Open-Laboratory/safeduino_mega_328/kicad/safeduino_mega_328.kicad_pcb

## KiCad design kicad/safeduino_mega_328.kicad_pcb (2023-07-11)

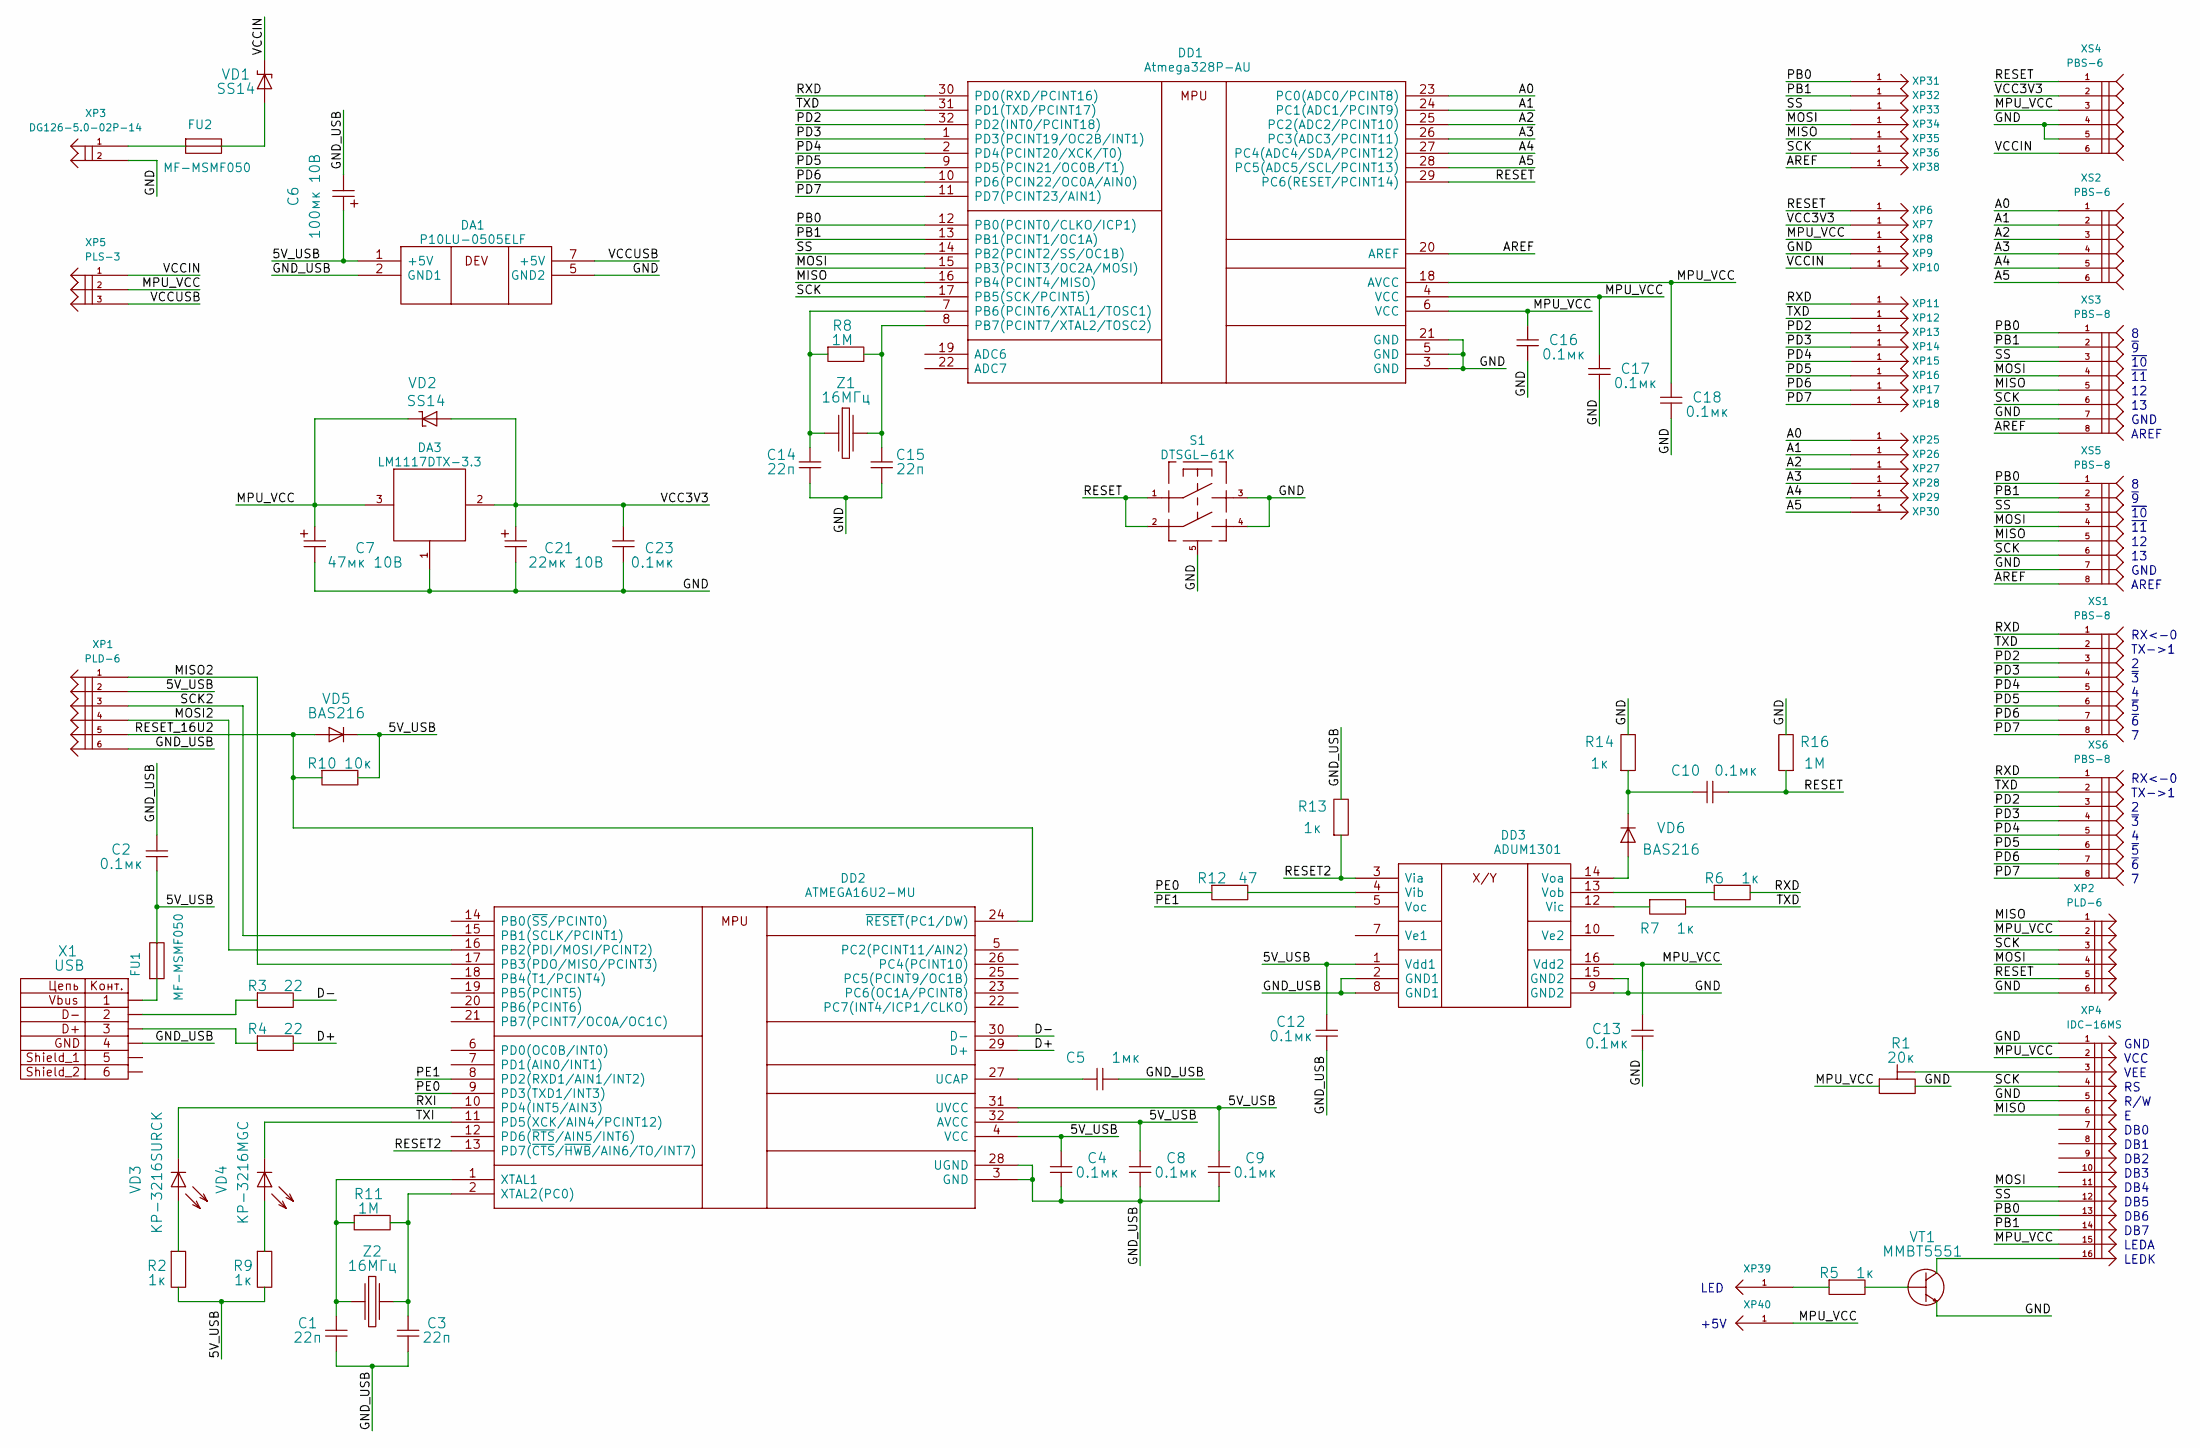
[picture p1: schematic safeduino_mega_328.kicad_sch, SafeDuino MEGA 328]

Parts:
C1, C3, C14, C15: 22п
C2, C4, C8, C9, C10, C12, C13, C16, C17, C18, C23: 0.1мк
C5: 1мк
C6: 100мк 10В
C7: 47мк 10В
C21: 22мк 10В
DA1: P10LU-0505ELF
DA3: LM1117DTX-3.3
DD1: Atmega328P-AU
DD2: ATMEGA16U2-MU
DD3: ADUM1301
FU1, FU2: MF-MSMF050
R1: 20к
R2, R5, R6, R7, R9, R13, R14: 1к
R3, R4: 22
R8, R11, R16: 1M
R10: 10к
R12: 47
S1: DTSGL-61K
VD1, VD2: SS14
VD3: KP-3216SURCK
VD4: KP-3216MGC
VD5, VD6: BAS216
VT1: MMBT5551
X1: USB
XP1, XP2: PLD-6
XP3: DG126-5.0-02P-14
XP4: IDC-16MS
XP5: PLS-3
XP6, XP7, XP8, XP9, XP10, XP11, XP12, XP13, XP14, XP15, XP16, XP17, XP18, XP25, XP26, XP27, XP28, XP29, XP30, XP31, XP32, XP33, XP34, XP35, XP36, XP38, XP39, XP40: (no value)
XS1, XS3, XS5, XS6: PBS-8
XS2, XS4: PBS-6
Z1, Z2: 16МГц

Connections:
/5V_USB: C2.1, C4.2, C6.1, C8.2, C9.2, C12.2, DA1.1 (+5V), DD2.4 (VCC), DD2.31 (UVCC), DD2.32 (AVCC), DD3.1 (Vdd1), FU1.2, R2.2, R9.2, R10.2, VD5.2, XP1.2
/A0: DD1.23 (PC0(ADC0/PCINT8)), XP25.1, XS2.1
/A1: DD1.24 (PC1(ADC1/PCINT9)), XP26.1, XS2.2
/A2: DD1.25 (PC2(ADC2/PCINT10)), XP27.1, XS2.3
/A3: DD1.26 (PC3(ADC3/PCINT11)), XP28.1, XS2.4
/A4: DD1.27 (PC4(ADC4/SDA/PCINT12)), XP29.1, XS2.5
/A5: DD1.28 (PC5(ADC5/SCL/PCINT13)), XP30.1, XS2.6
/AREF: DD1.20 (AREF), XP38.1, XS3.8, XS5.8
/D+: DD2.29 (D+), R4.2
/D-: DD2.30 (D-), R3.2
/GND: C7.2, C13.1, C14.2, C15.2, C16.2, C17.2, C18.2, C21.2, C23.2, DA1.5 (GND2), DA3.1 (com), DD1.3 (GND), DD1.5 (GND), DD1.21 (GND), DD3.9 (GND2), DD3.15 (GND2), R1.3, R14.2, R16.2, S1.3, S1.4, S1.5, VT1.1, XP2.6, XP3.2, XP4.1, XP4.5, XP9.1, XS3.7, XS4.4, XS4.5, XS5.7
/GND_USB: C1.2, C2.2, C3.2, C4.1, C5.2, C6.2, C8.1, C9.1, C12.1, DA1.2 (GND1), DD2.3 (GND), DD2.28 (UGND), DD3.2 (GND1), DD3.8 (GND1), R13.2, X1.4 (GND), XP1.6
/MISO: DD1.16 (PB4(PCINT4/MISO)), XP2.1, XP4.6, XP35.1, XS3.5, XS5.5
/MISO2: DD2.17 (PB3(PDO/MISO/PCINT3)), XP1.1
/MOSI: DD1.15 (PB3(PCINT3/OC2A/MOSI)), XP2.4, XP4.11, XP34.1, XS3.4, XS5.4
/MOSI2: DD2.16 (PB2(PDI/MOSI/PCINT2)), XP1.4
/MPU_VCC: C7.1, C13.2, C16.1, C17.1, C18.1, DA3.3 (Vin), DD1.4 (VCC), DD1.6 (VCC), DD1.18 (AVCC), DD3.16 (Vdd2), R1.1, VD2.2, XP2.2, XP4.2, XP4.15, XP5.2, XP8.1, XP40.1, XS4.3
/PB0: DD1.12 (PB0(PCINT0/CLKO/ICP1)), XP4.13, XP31.1, XS3.1, XS5.1
/PB1: DD1.13 (PB1(PCINT1/OC1A)), XP4.14, XP32.1, XS3.2, XS5.2
/PD2: DD1.32 (PD2(INT0/PCINT18)), XP13.1, XS1.3, XS6.3
/PD3: DD1.1 (PD3(PCINT19/OC2B/INT1)), XP14.1, XS1.4, XS6.4
/PD4: DD1.2 (PD4(PCINT20/XCK/T0)), XP15.1, XS1.5, XS6.5
/PD5: DD1.9 (PD5(PCIN21/OC0B/T1)), XP16.1, XS1.6, XS6.6
/PD6: DD1.10 (PD6(PCIN22/OC0A/AIN0)), XP17.1, XS1.7, XS6.7
/PD7: DD1.11 (PD7(PCINT23/AIN1)), XP18.1, XS1.8, XS6.8
/PE0: DD2.9 (PD3(TXD1/INT3)), R12.1
/PE1: DD2.8 (PD2(RXD1/AIN1/INT2)), DD3.5 (Voc)
/RESET: C10.2, DD1.29 (PC6(RESET/PCINT14)), R16.1, S1.1, S1.2, XP2.5, XP6.1, XS4.1
/RESET2: DD2.13 (PD7(~CTS/~HWB/AIN6/TO/INT7)), DD3.3 (Via), R13.1
/RESET_16U2: DD2.24 (~RESET(PC1/DW)), R10.1, VD5.1, XP1.5
/RXD: DD1.30 (PD0(RXD/PCINT16)), R6.2, XP11.1, XS1.1, XS6.1
/RXI: DD2.10 (PD4(INT5/AIN3)), VD3.2
/SCK: DD1.17 (PB5(SCK/PCINT5)), XP2.3, XP4.4, XP36.1, XS3.6, XS5.6
/SCK2: DD2.15 (PB1(SCLK/PCINT1)), XP1.3
/SS: DD1.14 (PB2(PCINT2/SS/OC1B)), XP4.12, XP33.1, XS3.3, XS5.3
/TXD: DD1.31 (PD1(TXD/PCINT17)), R7.2, XP12.1, XS1.2, XS6.2
/TXI: DD2.11 (PD5(XCK/AIN4/PCINT12)), VD4.2
/VCC3V3: C21.1, C23.1, DA3.2 (Vout), VD2.1, XP7.1, XS4.2
/VCCIN: VD1.2, XP5.1, XP10.1, XS4.6
/VCCUSB: DA1.7 (+5V), XP5.3
unnamed: C1.1, DD2.1 (XTAL1), R11.1, Z2.1
unnamed: C3.1, DD2.2 (XTAL2(PC0)), R11.2, Z2.2
unnamed: C5.1, DD2.27 (UCAP)
unnamed: C10.1, R14.1, VD6.2
unnamed: C14.1, DD1.7 (PB6(PCINT6/XTAL1/TOSC1)), R8.1, Z1.1
unnamed: C15.1, DD1.8 (PB7(PCINT7/XTAL2/TOSC2)), R8.2, Z1.2
unnamed: DD3.4 (Vib), R12.2
unnamed: DD3.12 (Vic), R7.1
unnamed: DD3.13 (Vob), R6.1
unnamed: DD3.14 (Voa), VD6.1
unnamed: FU1.1, X1.1 (Vbus)
unnamed: FU2.1, XP3.1
unnamed: FU2.2, VD1.1
unnamed: R1.2, XP4.3
unnamed: R2.1, VD3.1
unnamed: R3.1, X1.2 (D-)
unnamed: R4.1, X1.3 (D+)
unnamed: R5.1, XP39.1
unnamed: R5.2, VT1.2
unnamed: R9.1, VD4.1
unnamed: VT1.3, XP4.16

Notes on the sheet:
GND
RX<-0
DB2
AREF
TX->1
~{3}
DB6
DB5
~{6}
LEDA
DB7
LED
~{5}
VEE
DB3
~{10}
~{9}
DB1
~{11}
LEDK
+5V
R/W
DB4
VCC
DB0

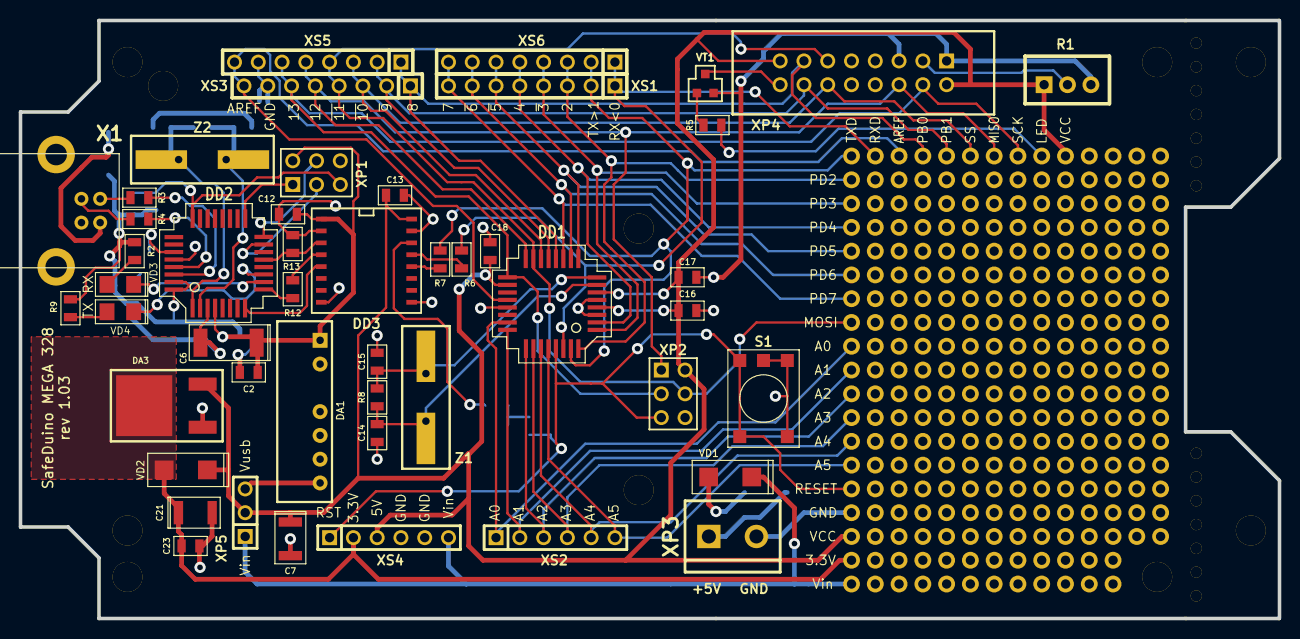
[picture p2: board safeduino_mega_328.kicad_pcb from above]

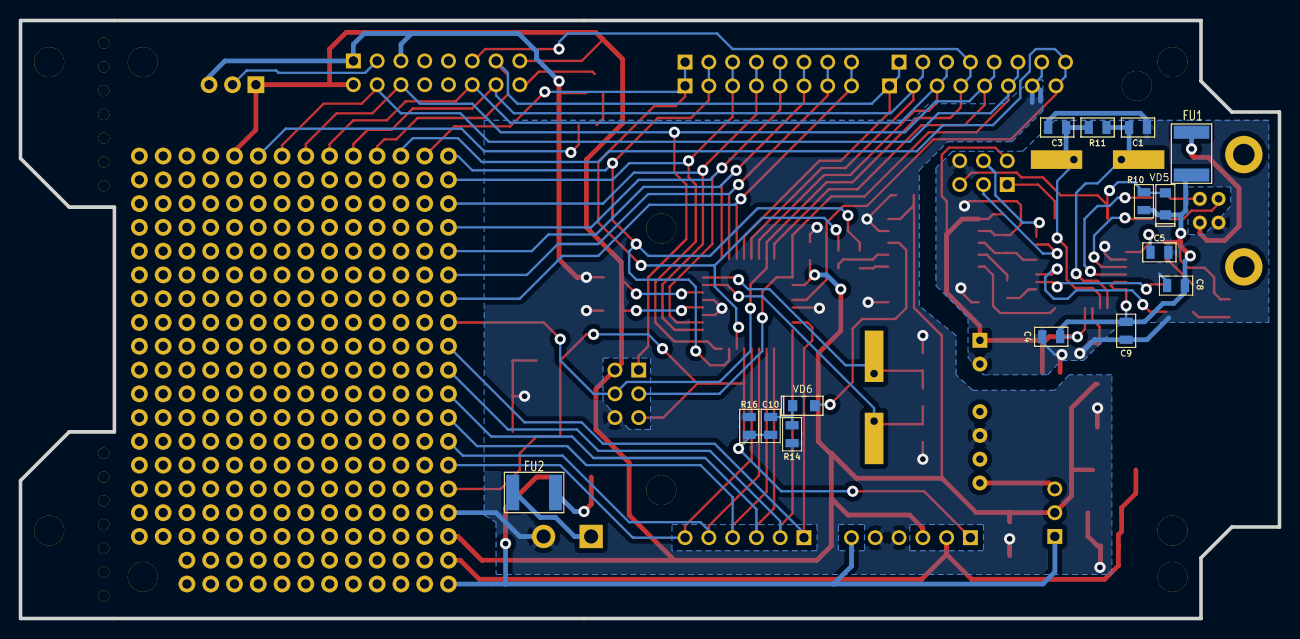
[picture p3: board safeduino_mega_328.kicad_pcb from below]

Board: 2 copper layers, 134.5 x 63.9 mm, 101 parts (15 on the bottom side), 61 nets.

Other parts of the board:
G447, G447#2, G447#3, G762/G447/HB11460: P***; 1_pin
HB11460/G762, HB11460/G762#2, HB11460/G762/arduino: P***; 1_pin
arduino: P***; 1_pin
arduino#2, arduino#3: P***; 1_pin
