Open-Laboratory/safeduino_mega_328/(commit log)

2016-02-19 Заменил FTDI на Atmega16u2.
    [safeduino_mega_328.sch]
2016-02-19 Начал переразводить печатную плату.
    [safeduino_mega_328.kicad_pcb, safeduino_mega_328.sch]
2016-02-20 Закончил разводку платы.
    [safeduino_mega_328.kicad_pcb]
2016-02-24 Добавил самовостанавливающиеся предохренители на 0.5А.
    [safeduino_mega_328.kicad_pcb, safeduino_mega_328.sch]
2016-03-10 Заменил резистор R15 на диод VD6 для защиты ADUM от попадания напряжения.
    [safeduino_mega_328.kicad_pcb, safeduino_mega_328.sch]
2016-05-23 SafeDuino MEGA 328 v1.02 полностью готова к отправке на изготовление.
    [safeduino_mega_328.kicad_pcb, safeduino_mega_328.sch]
2016-07-13 Исправли ошибку на плате SafeDuino MEGA 328(был не соединён контакт PE0 на плате).
    [safeduino_mega_328.kicad_pcb, safeduino_mega_328.sch]
2018-07-20 Поправил шелкографию на плате.
    [safeduino_mega_328.kicad_pcb]
2023-07-11 Перевёл проект на Kicad 6.0.
    [safeduino_mega_328.kicad_pcb, safeduino_mega_328.kicad_sch, safeduino_mega_328.sch]
